Bennmane27/ccep-soda/apercus/schema.jpg

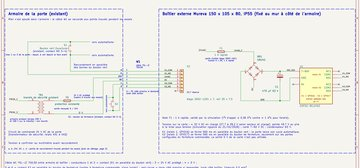
apercus/schema.jpg
