Bennmane27/ccep-soda/apercus/boitier.jpg

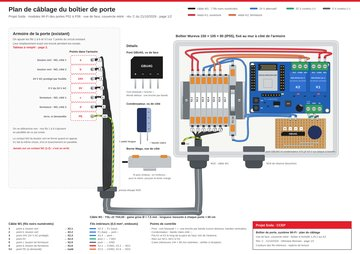
apercus/boitier.jpg
