Bennmane27/ccep-soda/README.md

# Projet Soda : portes rapides et Spot

Page du projet (CCEP, alternance d'Othmane Bennani) : animation du passage, documents techniques, demande à l'informatique, liste d'achat.

Publiée avec GitHub Pages (branche `main`, dossier racine).
