Bennmane27/ccep-soda/fichiers/plan_armoire.pdf

# Armoire de la porte : ce qui existe, ce qu'on cherche

Projet Soda · porte de l'armoire vue de l'arrière et intérieur, d'après les photos de l'armoire · rév. D · page 2/2

câble W1 : nos 7 fils | fils existants : couleurs de la photo | * à confirmer sur place

Rien n'est supposé : les points où se branchent nos fils sont trouvés pendant les essais, puis notés en bas.

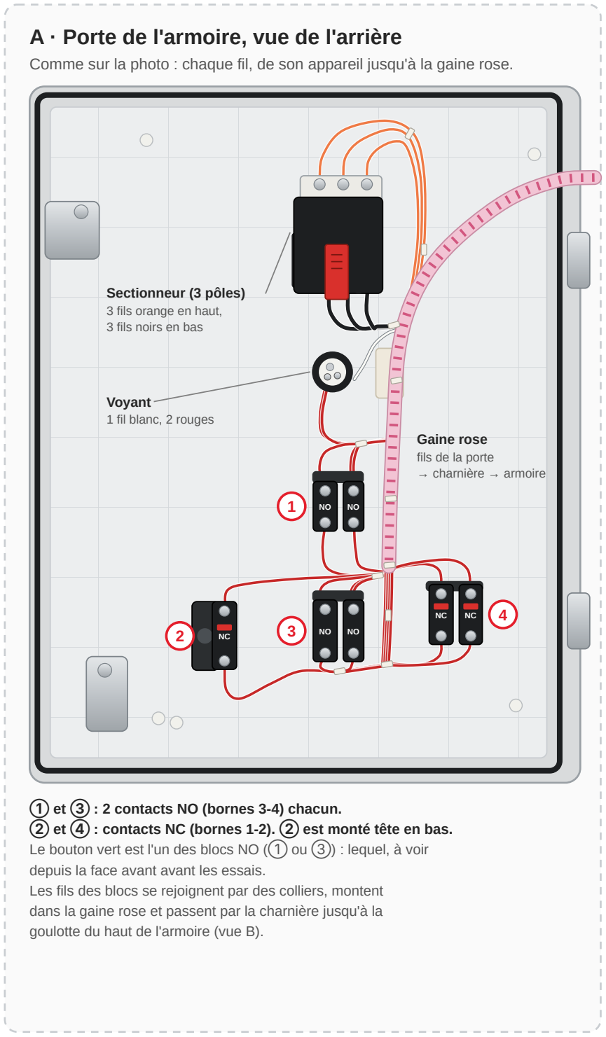
[picture p3: figure]
Sectionneur (3 pôles) 3 fils orange en haut, 3 fils noirs en bas; Voyant 1 fil blanc, 2 rouges; Gaine rose fils de la porte → charnière → armoire; depuis la face avant avant les essais.; goulotte du haut de l'armoire (vue B).

## A · Porte de l'armoire, vue de l'arrière

Comme sur la photo : chaque fil, de son appareil jusqu'à la gaine rose.

① et ③ : 2 contacts NO (bornes 3-4) chacun.
② et ④ : contacts NC (bornes 1-2). ② est monté tête en bas. Le bouton vert est l'un des blocs NO (① ou ③) : lequel, à voir

Les fils des blocs se rejoignent par des colliers, montent
dans la gaine rose et passent par la charnière jusqu'à la

## B · Intérieur de l'armoire

Les appareils et leurs fils, comme sur la photo. Nos points de raccordement ne sont pas dessinés.

goulotte

goulotte

goulotte

TRANSFO

de sécurité

230V 400V

0 24V

TH1 | F2

N

F3

relais IR des cellules

T1

KA2 | KA1 | KA3

KMF

KM1

229945

gaine rose : fils de la porte → entre dans la goulotte

rangée de bornes | bornes + terre (vert-jaune)

compteur

presse-étoupes : les câbles du terrain arrivent par le dessous

Fils dessinés d'après la photo. Dans les goulottes, leur trajet ne se voit pas : on voit où ils entrent et où ils ressortent.

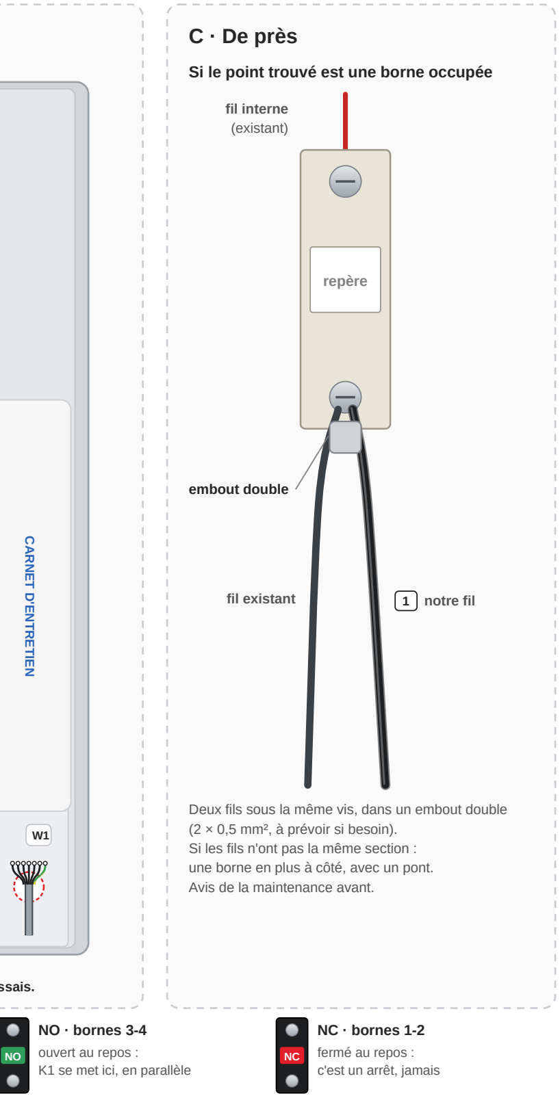
[picture p4: figure]
CARNET D'ENTRETIEN; C · De près; repère; fil interne (existant); embout double; fil existant; 1 notre fil; (2 × 0,5 mm², à prévoir si besoin). Si les fils n'ont pas la même section : une borne en plus à côté, avec un pont. Avis de la maintenance avant.; NO · bornes 3-4; ouvert au repos : K1 se met ici, en parallèle; NC · bornes 1-2; fermé au repos : c'est un arrêt, jamais

Câble W1 : arrive par le bas (entrée à définir avec la maintenance), 7 fils libres ; leurs points sont trouvés pendant les essais.

Si le point trouvé est une borne occupée

Deux fils sous la même vis, dans un embout double

## Les 7 points de raccordement : à remplir pendant les essais, armoire consignée

Fil | Point | Ce qu'il faut trouver | Trouvé où (repère, borne ou appareil)
1 | a | un côté du contact NO du bouton vert (ouverture)
2 | b | l'autre côté du même contact NO
3 | 24V | le 24 V AC, protégé par un fusible de l'armoire
4 | 0V | le 0 V de ce 24 V AC
5 | c | un côté du contact NO du bouton de fermeture (portes concernées)
6 | d | l'autre côté du même contact NO
VJ | PE | la terre, si la maintenance le demande

## Projet Soda · CCEP

Armoire de la porte : ce qui existe, ce qu'on cherche D'après les photos de l'armoire GE ARIA L du 21/10/2026 Rév. D · 22/10/2026 · Othmane Bennani · page 2/2
Points de raccordement : notés pendant les essais
