Bennmane27/ccep-soda/fichiers/plan_boitier.pdf

# Plan de câblage du boîtier de porte

Projet Soda · modules Wi-Fi des portes P01 à P06 · vue de face, couvercle retiré · rév. C du 21/10/2026 · page 1/2

câble W1 : 7 fils noirs numérotés | 24 V alternatif | 32 V continu (+) | 0 V continu (−)
relais K1, ouverture | relais K2, fermeture

## Armoire de la porte (existant)

On ajoute les fils 1 à 6 et VJ sur 7 points du circuit existant. Leur emplacement exact est trouvé pendant les essais. Tableau à remplir : page 2.
Points dans l'armoire
bouton vert · NO, côté 1 | a
bouton vert · NO, côté 2 | b
24 V AC protégé par fusible | 24V
0 V du 24 V AC | 0V
fermeture · NO, côté 1 | c
fermeture · NO, côté 2 | d
terre, si demandée | PE

On ne débranche rien : nos fils 1 à 6 s'ajoutent
en parallèle de ce qui existe.

Le contact NO du bouton vert se ferme quand on appuie. K1 fait la même chose, d'où le branchement en parallèle.

Jamais sur un contact NC (1-2) : c'est un arrêt.

presse-étoupe M20

1

2

3

4

5

6

VJ

Câble W1 · YSL-JZ 7G0,50 · gaine grise Ø ≈ 7,5 mm · longueur mesurée à chaque porte + 50 cm

Boîtier Mureva 150 × 105 × 80 (IP55), fixé au mur à côté de l'armoire X².1 | X².2 | X².3 | X².4 | X².5 | X².6 | X².7 | F1 1A

pont GBU4G et condensateur 470 µF 63 V sur plaque à bandes

GBU4G

+ | ~ | ~ | − | − − −
+ | −

ESP32-WROOM-32E
SRD-05VDC-SL-C

10A 250VAC 10A 30VDC
K2

SRD-05VDC-SL-C

10A 250VAC 10A 30VDC
K1
NC2 COM2 NO2 | NC1 COM1 NO1
VCC GND | 5V

7-60V IO0

EN

P4 · programmation

470

M16 · câble W1 | M16 de réserve (bouchon)
1 | 2 | 3 | 4 | 5 | 6

VJ

## Détails

Pont GBU4G, vu de face

### GBU4G

+ | ~ | ~ | −

Coin biseauté = broche +.
Monté debout : une broche par bande.

Condensateur, vu de côté

−
−
−
−
+ patte longue | − bande claire

Borne Wago, vue de côté

fil avec embout : on l'enfonce ; pour le retirer, pousser le levier orange

Câble W1 (fils noirs numérotés)

1 | point a, bouton vert | → X2.1
2 | point b, bouton vert | → X2.2
3 | point 24V (24 V AC protégé) | → X2.3
4 | point 0V | → X2.4
5 | point c, bouton de fermeture | → X2.5
6 | point d, bouton de fermeture | → X2.6
VJ | point PE (si demandé) | → isolé

Fils intérieurs (0,5 mm², embouts)

X2.3 → F1 (haut)
F1 (bas) → pont ~
X2.4 → pont ~
pont + → 7-60V
pont − → GND
X2.1 → COM1, X2.2 → NO1
X2.5 → COM2, X2.6 → NO2

Points de contrôle

- Pont : coin biseauté = +, une broche par bande (cuivre dessous, bandes verticales).
- Condensateur : bande claire côté −.
- Fils K1 et K2 le long de la paroi du haut, loin de l'antenne.
- Rien sur NC1, NC2 ni 5V.
- Cotes intérieures 144 × 99 mm estimées : vérifier à réception.

### Projet Soda · CCEP

Boîtier de porte, système Wi-Fi : plan de câblage Vue de face, couvercle retiré · boîtier à l'échelle 1,25:1 sur A3 Rév. C · 21/10/2026 · Othmane Bennani · page 1/2 Couleurs des fils intérieurs : repères de lecture
