Bennmane27/ccep-soda/apercus/armoire.jpg

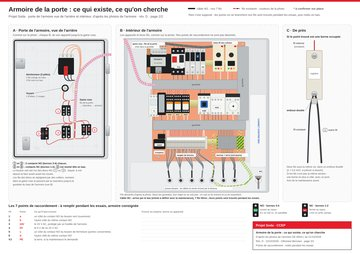
apercus/armoire.jpg
