Bennmane27/ccep-soda/apercus/reseau.jpg

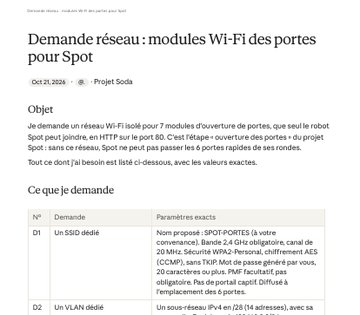
apercus/reseau.jpg
