Bennmane27/ccep-soda/fichiers/schema_boitier_porte_revE.png

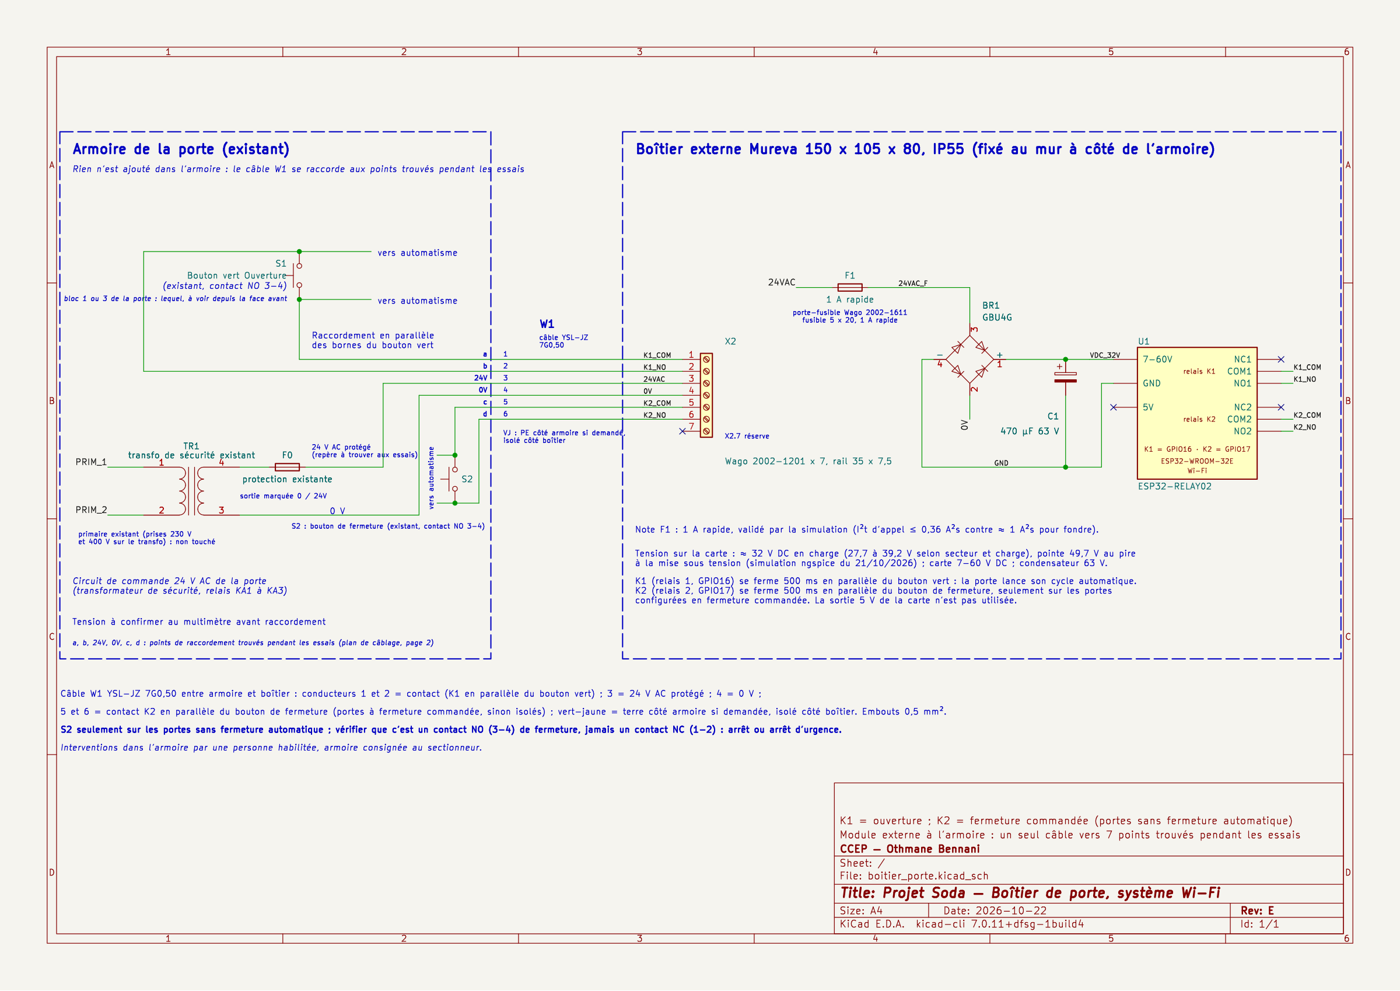
fichiers/schema_boitier_porte_revE.png
