Bennmane27/ccep-soda/fichiers/liste_achat_portes_spot.xlsx

Projet Soda — Liste d'achat système Wi-Fi, 6 portes (21/10/2026, fermeture commandée incluse)
Chiffres en bleu = saisies modifiables (prix du lot, nombre de lots). Cellule jaune = prix à chiffrer. Lignes « Conditionnel » : 0 lot commandé, voir « Nb si retenu ». Lien d'achat souligné : cliquer pour ouvrir la fiche du produit (ou une recherche Amazon quand aucune fiche précise n'existe). Prix HT et disponibilités relevés les 20 et 21/10/2026 (RS, Rexel).
N° | Catégorie | Article | Rôle | Fournisseur | Référence | Lien d'achat | Conditionnement | Prix HT du lot (€) | Nb de lots à commander | Total HT (€) | Quantité utile | Statut | Remarque | Nb si retenu | Total si retenu (€)
1 | Module de porte | Carte Seeit ESP32-RELAY02 (Wi-Fi, 2 relais) | Reçoit les ordres de Spot par le Wi-Fi : relais K1 = ouverture, relais K2 = fermeture (portes sans fermeture automatique) | RS | 286-3995 | Fiche RS (https://fr.rs-online.com/web/p/products/2863995) | à l'unité | 27.20 € | 7 | 190.40 € | 6 + 1 rechange | À commander | Disponibilité RS au 21/10 : 1 prête à expédier, 17 de plus à partir du 26/10/2026. Prix dégressif : 25,84 € dès 5. À commander en premier.
2 | Module de porte | Câble FTDI TTL-232R-3V3 (USB vers série 3,3 V) | Programmer et configurer les cartes | RS | 429-307 | Fiche RS (https://fr.rs-online.com/web/p/products/0429307) | à l'unité | 23.20 € | 2 | 46.40 € | 2 | À commander | Version 3,3 V obligatoire pour l'ESP32. Un de secours.
3 | Module de porte | Entretoises nylon M3 et vis (assortiment) | Fixer la carte au fond de la boîte (4 par carte, 10 mm) | Amazon | à choisir | Recherche Amazon (https://www.amazon.fr/s?k=kit+entretoises+nylon+M3) | assortiment |  | 1 | à chiffrer | 24 | À commander | À chiffrer. Prix à relever sur Amazon.
4 | Boîtier externe | Boîte Mureva 150 x 105 x 80, IP55 | Boîtier du module, fixé au mur à côté de l'armoire | Rexel | SCHENN05087 | Fiche Rexel (https://www.rexel.fr/frx/Catégorie/Appareillage-et-contrôle-du-bâtiment/Boite-d%27encastrement-et-de-dérivation/Boite-étanche/Mureva-Box---boîte-de-dérivation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) | à l'unité | 24.96 € | 6 | 149.76 € | 6 | À commander | Profondeur intérieure à mesurer à réception (environ 74 mm attendus).
5 | Boîtier externe | Rail DIN 35 x 7,5 mm perforé, barre de 1 m | Support des bornes : un tronçon de 6 cm vertical par boîte | RS | 467-416 | Fiche RS (https://fr.rs-online.com/web/p/rails-din/0467416) | paquet de 4 barres | 27.13 € | 1 | 27.13 € | 6 x 6 cm | À commander | Remplace le rail 35 x 15 mm (Rexel BIZ200235) : 7,5 mm de moins en hauteur sous le couvercle.
6 | Boîtier externe | Borne à ressort Wago 2002-1201, 2,5 mm² | X2.1-X2.2 contact K1 (ouverture), X2.3-X2.4 24 V AC, X2.5-X2.6 contact K2 (fermeture), X2.7 réserve | RS | 507-6535 | Fiche RS (https://fr.rs-online.com/web/p/borniers-pour-rail-din/5076535) | paquet de 10 | 9.34 € | 4 | 37.36 € | 6 ou 7 par boîte (X2.1 à X2.7) | À commander | Un paquet de plus pour les portes à fermeture commandée (2 bornes de plus par boîte).
7 | Boîtier externe | Borne porte-fusible Wago 2002-1611 (fusible 5 x 20) | F1 : protège le 24 V AC pris dans l'armoire | RS | 758-1705 | Fiche RS (https://fr.rs-online.com/web/p/borniers-pour-rail-din/7581705) | paquet de 10 | 49.29 € | 1 | 49.29 € | 6 + 4 réserve | À commander | Remplace le Phoenix UT 4-HESI (73 mm de haut) : 57,2 mm au-dessus du rail, passe sous le couvercle. Même gamme que les bornes 2002.
8 | Boîtier externe | Fusible 5 x 20 mm 1 A rapide | Fusible de F1 | RS | 630-826 | Fiche RS (https://fr.rs-online.com/web/p/products/0630826) | boîte de 10 | 5.76 € | 1 | 5.76 € | 6 + 4 réserve | À commander | Calibre validé par la simulation. Rupture RS annoncée jusqu'au 27/11/2026 (relevé du 21/10) : tout fusible 5 x 20 mm 1 A rapide 250 V convient.
9 | Boîtier externe | Plaque d'extrémité Wago 2002-1291 | Ferme le côté ouvert de la dernière borne | Rexel | WAG2002-1291 | Fiche Rexel (https://www.rexel.fr/frx/Catégorie/Produits-Industriels/Connectique-et-raccordement/Bloc-de-jonction-borne-de-câblage/TOPJOB%27S-Plaque-d%27extrémité-et-inter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) | à l'unité |  | 6 | à chiffrer | 6 | À commander | À chiffrer. Prix visible après connexion au compte Rexel.
10 | Boîtier externe | Butée d'arrêt Wago 249-116 | Bloque la rangée de bornes sur le rail | RS | 796-0460 | Fiche RS (https://fr.rs-online.com/web/p/products/7960460) | paquet de 5 | 4.31 € | 3 | 12.93 € | 12 (2 par boîte) | À commander
11 | Boîtier externe | Presse-étoupe M16 IP68 nylon, câble Ø 5 à 10 mm | Entrée du câble dans la boîte (1 utilisé, 1 réserve) | RS | 214-1064 | Fiche RS (https://fr.rs-online.com/web/p/products/2141064) | sachet de 10 | 6.23 € | 2 | 12.46 € | 12 | À commander | Stock RS indisponible au 21/10 : vérifier, ou prendre un presse-étoupe M16 IP68 équivalent (câble Ø 5 à 10 mm).
12 | Alimentation de la carte | Pont redresseur onsemi GBU4G (400 V, 4 A) | Transforme le 24 V AC de l'armoire en continu | RS | 806-7121 | Fiche RS (https://fr.rs-online.com/web/p/products/8067121) | tube de 20 | 17.66 € | 1 | 17.66 € | 6 | À commander | La carte accepte 7 à 60 V continu sur son bornier : environ 32 V après redressement.
13 | Alimentation de la carte | Condensateur 470 µF 63 V radial 105 °C | Lisse la tension redressée | RS | 711-1615 | Fiche RS (https://fr.rs-online.com/web/p/products/7111615) | sachet de 10 | 6.20 € | 1 | 6.20 € | 6 | À commander | Respecter la polarité.
14 | Alimentation de la carte | Plaque à bandes (veroboard) | Support du pont et du condensateur | Amazon | à choisir | Recherche Amazon (https://www.amazon.fr/s?k=plaque+à+bandes+veroboard) | plaque |  | 1 | à chiffrer | 6 morceaux de 45 x 32 mm | À commander | À chiffrer. Pas de plaque à bandes trouvée sur RS France ; n'importe quelle plaque au pas de 2,54 mm convient.
15 | Liaison avec l'armoire | Câble souple YSL-JZ 7G0,50 | Fils 1-2 contact K1 (ouverture), 3-4 24 V AC, 5-6 contact K2 (fermeture), vert-jaune terre | Rexel | FILYSLJZ7G0,5TGL | Fiche Rexel (https://www.rexel.fr/frx/Catégorie/Fils-et-Câbles/Câble-de-contrôle%2C-manutention-et-instrumentation/Câble-de-contrôle%2C-commande-et-liaison-moteur/Câble-so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) | au mètre | 1.26 € | 20 | 25.20 € | environ 3 m par porte | À commander | Longueur à mesurer à chaque porte.
16 | Liaison avec l'armoire | Presse-étoupe M20 IP68 nylon | Entrée du câble dans l'armoire de la porte | RS | 669-4664 | Fiche RS (https://fr.rs-online.com/web/p/products/6694664) | sachet de 5 | 7.05 € | 2 | 14.10 € | 6 | À commander | Selon le diamètre de l'entrée libre de l'armoire.
17 | Liaison avec l'armoire | Embouts de câblage isolés 0,5 mm² | Sertis sur chaque fil | RS | 178-7287 | Fiche RS (https://fr.rs-online.com/web/p/products/1787287) | sachet de 100 | 2.90 € | 2 | 5.80 € | environ 20 par porte | À commander
18 | Si nécessaire | Routeur de voyage TP-Link TL-WR902AC | Réseau Wi-Fi de test si l'informatique ne donne pas d'accès à temps | RS | 286-4650 | Fiche RS (https://fr.rs-online.com/web/p/products/2864650) | à l'unité | 91.65 € | 0 | 0.00 € | 1 | Conditionnel | Ce point d'accès doit lui aussi être autorisé par l'informatique. | 1 | 91.65 €
19 | Si nécessaire | Clé Wi-Fi USB TP-Link Archer T2U Plus | Relier le CORE I/O au réseau de test | RS | 255-8427 | Fiche RS (https://fr.rs-online.com/web/p/products/2558427) | à l'unité | 32.79 € | 0 | 0.00 € | 1 | Conditionnel | Seulement avec le routeur de test ; pilote Linux à vérifier. | 1 | 32.79 €
20 | Si nécessaire | Foret étagé 6 à 30,5 mm | Percer l'armoire s'il n'y a pas d'entrée libre | RS | 399-0934 | Fiche RS (https://fr.rs-online.com/web/p/products/3990934) | à l'unité | 78.80 € | 0 | 0.00 € | 1 | Conditionnel | Avec l'accord de la maintenance. | 1 | 78.80 €
21 | Si nécessaire | Redresseur rail DIN Zander Aachen 456100 | Variante industrielle du pont redresseur | RS | 562-114 | Fiche RS (https://fr.rs-online.com/web/p/products/0562114) | à l'unité | 61.70 € | 0 | 0.00 € | 6 | Conditionnel | Seulement si la maintenance refuse le montage sur plaque ; demande un coffret plus grand. | 6 | 370.20 €
22 | Si nécessaire | Alimentation Mean Well HDR-15-24 | Si le transformateur de l'armoire est trop chargé | RS | 145-7862 | Fiche RS (https://fr.rs-online.com/web/p/products/1457862) | à l'unité | 18.93 € | 0 | 0.00 € | 1 par porte concernée | Conditionnel | Amène du 230 V dans la boîte : à éviter si possible. | 1 | 18.93 €
 |  |  |  |  |  |  |  |  | Total à commander | 600.45 € |  |  |  | Si tous retenus | 592.37 €
Articles « à chiffrer » non comptés dans le total. Total conditionnel : coût si chaque article « Si nécessaire » est retenu avec la quantité « Nb si retenu ».
