Bennmane27/ccep-soda/dossiers/boitier/fichiers/boitier_porte.kicad_sch

## KiCad design dossiers/boitier/fichiers/boitier_porte.kicad_sch (2026-10-22, last stored version)

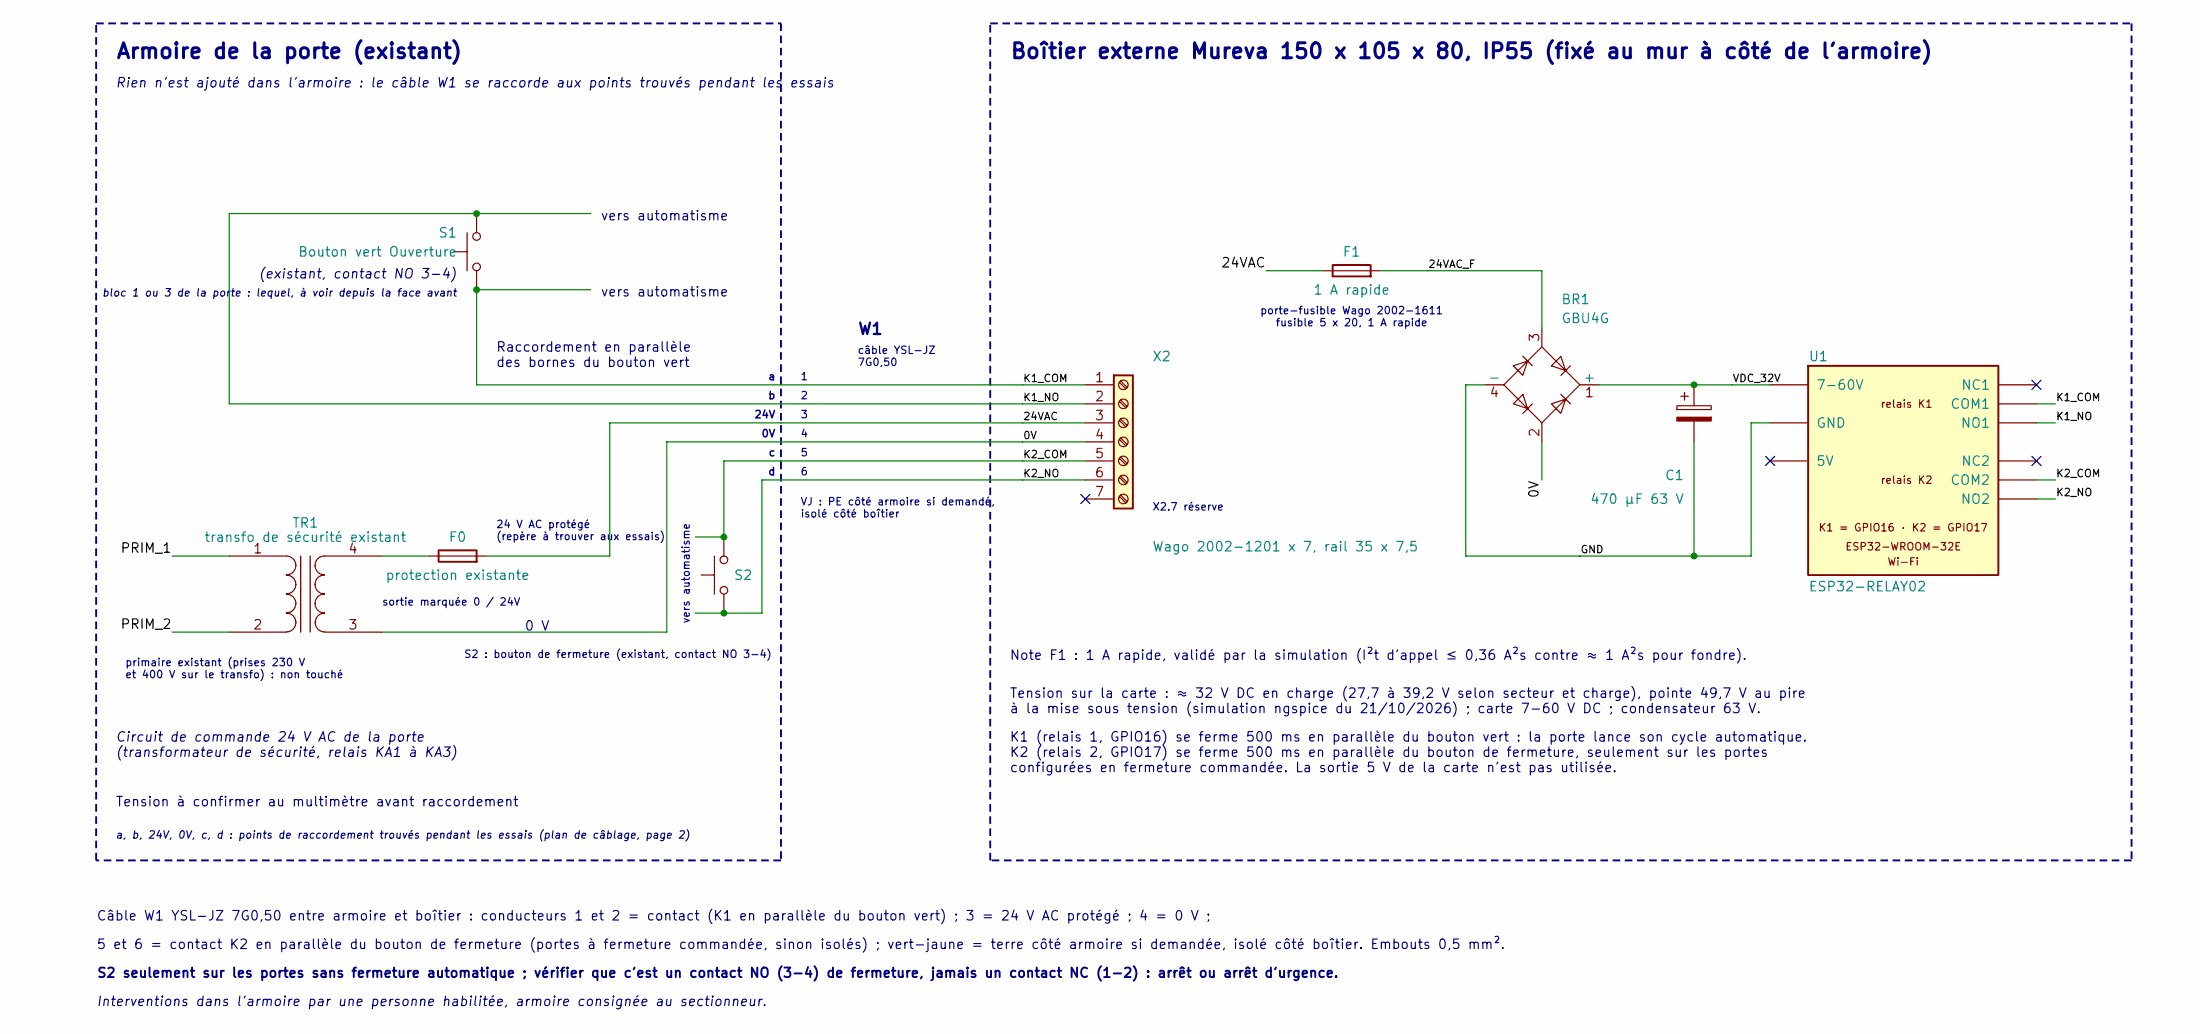
[picture p8: schematic boitier_porte.kicad_sch]

Parts:
BR1: GBU4G
C1: 470 µF 63 V
F0: protection existante
F1: 1 A rapide
S1: Bouton vert Ouverture
S2: Bouton de fermeture
TR1: transfo de sécurité existant
U1: ESP32-RELAY02
X2: Wago 2002-1201 x 7, rail 35 x 7,5

Connections:
0V: BR1.2, TR1.3 (SA), X2.4
24VAC: F0.2, F1.1, X2.3
24VAC_F: BR1.3, F1.2
GND: BR1.4 (-), C1.2, U1.GND
K1_COM: S1.1, U1.COM1, X2.1
K1_NO: S1.2, U1.NO1, X2.2
K2_COM: S2.2, U1.COM2, X2.5
K2_NO: S2.1, U1.NO2, X2.6
unnamed: F0.1, TR1.4 (SB)
PRIM_1: TR1.1 (AA)
PRIM_2: TR1.2 (AB)
VDC_32V: BR1.1 (+), C1.1, U1.7-60V

Notes on the sheet:
Armoire de la porte (existant)
Rien n'est ajouté dans l'armoire : le câble W1 se raccorde aux points trouvés pendant les essais
Boîtier externe Mureva 150 x 105 x 80, IP55 (fixé au mur à côté de l'armoire)
vers automatisme
(existant, contact NO 3-4)
bloc 1 ou 3 de la porte : lequel, à voir depuis la face avant
Raccordement en parallèle des bornes du bouton vert
primaire existant (prises 230 V et 400 V sur le transfo) : non touché
sortie marquée 0 / 24V
24 V AC protégé (repère à trouver aux essais)
0 V
Circuit de commande 24 V AC de la porte (transformateur de sécurité, relais KA1 à KA3)
Tension à confirmer au multimètre avant raccordement
S2 : bouton de fermeture (existant, contact NO 3-4)
24V
a, b, 24V, 0V, c, d : points de raccordement trouvés pendant les essais (plan de câblage, page 2)
câble YSL-JZ 7G0,50
VJ : PE côté armoire si demandé, isolé côté boîtier
X2.7 réserve
porte-fusible Wago 2002-1611 fusible 5 x 20, 1 A rapide
Note F1 : 1 A rapide, validé par la simulation (I²t d'appel ≤ 0,36 A²s contre ≈ 1 A²s pour fondre).
Tension sur la carte : ≈ 32 V DC en charge (27,7 à 39,2 V selon secteur et charge), pointe 49,7 V au pire à la mise sous tension (simulation ngspice du 21/10/2026) ; carte 7-60 V DC ; condensateur 63 V.
K1 (relais 1, GPIO16) se ferme 500 ms en parallèle du bouton vert : la porte lance son cycle automatique. K2 (relais 2, GPIO17) se ferme 500 ms en parallèle du bouton de fermeture, seulement sur les portes configurées en fermeture commandée. La sortie 5 V de la carte n'est pas utilisée.
Câble W1 YSL-JZ 7G0,50 entre armoire et boîtier : conducteurs 1 et 2 = contact (K1 en parallèle du bouton vert) ; 3 = 24 V AC protégé ; 4 = 0 V ;
5 et 6 = contact K2 en parallèle du bouton de fermeture (portes à fermeture commandée, sinon isolés) ; vert-jaune = terre côté armoire si demandée, isolé côté boîtier. Embouts 0,5 mm².
S2 seulement sur les portes sans fermeture automatique ; vérifier que c'est un contact NO (3-4) de fermeture, jamais un contact NC (1-2) : arrêt ou arrêt d'urgence.
Interventions dans l'armoire par une personne habilitée, armoire consignée au sectionneur.
