Bennmane27/ccep-soda/(commit log)

2026-10-22 Publish project website
    [Achat_materiel_v3_WiFi.xlsx, boitier_porte.kicad_sch]
2026-10-22 Update published project
    [boitier_porte.kicad_sch, liste_achat_portes_spot.xlsx]
